acrylic-origami/tail-3dof/bom.xlsx

Sheet: Export Summary
This document was exported from Numbers. Each table was converted to an Excel worksheet. All other objects on each Numbers sheet were placed on separate worksheets. Please be aware that formula calculations may differ in Excel.
Numbers Sheet Name | Numbers Table Name | Excel Worksheet Name
Orders
 | Overview | Orders - Overview
 | Efficiency analysis | Orders - Efficiency analysis
 | “All Drawings from the Sheet” | Orders - Drawings
Home Depot
 | Table 1 | Home Depot
Lowe's
 | Table 1 | Lowe's
Fry's
 | Table 1 | Fry's
Digikey
 | Table 1 | Digikey
Amazon
 | Table 1 | Amazon
Hobbyking
 | Table 1 | Hobbyking
Amain
 | Table 1 | Amain
Hobbywing
 | Table 1 | Hobbywing
ServoCity
 | Table 1 | ServoCity
Mouser
 | Table 1 | Mouser
McMaster-Carr
 | Table 1 | McMaster-Carr

Sheet: Orders - Overview
Overview
index | Provider | Date | Desc | Base + Tax | Shipping
1 | Amazon | 2020-03-10 | Grey fur | $38.13 | 0
2 | Hobbyking | 2020-03-21 | Batteries & chargers | $78.85 | 0
3 | Home Depot | 2020-03-21 | Alum bar, plate, ? | $41.64 | 0
4 | Amazon | 2020-03-21 | Big assortment of hardware | $290.04 | 0
5 | Amazon | 2020-03-23 | Snips, shrink wrap & limit switches | $27.66 | 0
6 | Digikey | 2020-03-23 | LEDs, LED drivers, DC/DC, low-dropout comparators, PFETs, misc passives | $94.46 | $4.99
7 | Fry’s | 2020-03-28 | Shrink tubing, wire, breadboard | $23.97 | 0
8 | Lowe’s | 2020-03-28 | Clamps, 1/4” bore | $18.18 | 0
9 | DigiKey | 2020-03-30 | STM32, toggle switches, probes | $27.08 | $8.99
10 | AMain | 2020-03-30 | HS D645 servo | $38.33 | $1.99
11 | Home Depot | 2020-04-11 | Misc tools & mech | $24.22 | 0
12 | Home Depot | 2020-04-12 | ? | $12.88 | 0
13 | ServoCity | 2020-04-13 | Replacement gears for D645, shaft coupler | $29.53 | $6.99
14 | Hobbywing | 2020-04-13 | Sensored BLDC + ESC | $105.08 | 0
15 | DigiKey | 2020-04-13 | Nucleo + LED drivers + ADCs + NFETs | $80.32 | $4.99
16 | Treatstock | 2020-04-16 | Mounts & holders | $18.01 | $4.99
17 | Home Depot | 2020-04-25 | Solder, misc tools | $21.97 | 0
18 | Home Depot | 2020-04-26 | Lock wash, velcro | $4.52 | 0
19 | Home Depot | 2020-05-03 | Misc mech, fabric velcro | $11.03 | 0
20 | Fry’s | 2020-05-16 | USB cables | $13.09 | 0
21 | Home Depot | 2020-05-25 | Glue, M3 lock nuts, joystick, misc. fillup | $11.07 | 0
22 | Mouser | 2020-05-27 | Drivers, controller parts, mic #2 | 82.8 | $7.99
23 | RobotDyn | 2020-05-27 | STM-Minis | $9.18 | $4.29
24 | Amazon | 2020-06-01 | Fuses + batteries | $16.62 | 0
24 | Hobbywing | 2020-06-03 | Quicrun G2 25.5T | $51.47 | 0
25 | Home Depot | 2020-06-11 | Webbing strap (tie-down) | $5.00 | 0
26 | McMaster-Carr | 2020-06-21 | Torsion springs, M2.6 screws | $12.73 | $6.89
27
Totals |  |  |  | 1187.86 | 52.11
Grand total |  |  |  | 1239.97

Sheet: Orders - Efficiency analysis
Efficiency analysis
 | Loss | Unused | Oversupplied | Tools | Total loss (+ tax, w/o ship) | Non-tool total (+tax, w/o ship) | Efficiency
 | 153.167 | 151.45 | 156.1614 | 142.1 | 503.400402 | 1032.61575 | 0.5124997832

Sheet: Home Depot
Table 1
 | Date | Name | Unit price | QTY | Total | Loss | Unused | Oversupplied | Tool
 | 2020-04-11 | Slim taper file | 5.97 | 1 | 5.97 |  |  |  | 1
 | 2020-04-11 | 9/64” bit | 1.97 | 1 | 1.97 |  |  |  | 1
 | 2020-04-11 | M3 lock washers | 0.65 | 1 | 0.65
 | 2020-04-11 | Dewalt snap blades | 2.38 | 1 | 2.38 |  |  |  | 1
 | 2020-04-11 | #8-32 3/8” machine screws | 1.18 | 1 | 1.18
 | 2020-04-11 | 11/32” bit | 4.97 | 1 | 4.97
 | 2020-04-11 | M3 lock nuts 4pk | 0.98 | 4 | 3.92
 | 2020-04-11 | #6-32 3/8” machine screws | 1.18 | 1 | 1.18
 | 2020-04-25 | 10A fuses | 2.25 | 1 | 2.25
 | 2020-04-25 | Micro screwdriver set | 2.97 | 1 | 2.97 |  |  |  | 1
 | 2020-04-25 | Lead-free solder | 9.47 | 1 | 9.47
 | 2020-04-25 | 10pc SAE imperial hex keys | 5.47 | 1 | 5.47 |  |  |  | 1
 | 2020-04-26 | #8 lock washers | 1.18 | 1 | 1.18 |  | 1
 | 2020-04-26 | Industrial-strength stick-on Velcro | 2.97 | 1 | 2.97 |  |  | 0.7
 | 2020-05-03 | Fabric velcro | 5.97 | 1 | 5.97 |  |  | 0.9
 | 2020-05-03 | Nylon spacers 2pk | 0.62 | 1 | 0.62
 | 2020-05-03 | #6-32 3/4” machine screws | 1.18 | 1 | 1.18
 | 2020-05-03 | #6-32 1-1/4” machine screws | 1.18 | 1 | 1.18
 | 2020-05-03 | #6-32 1/2” machine screws | 1.18 | 1 | 1.18

Sheet: Lowe's
Table 1
 | Date | Name | Unit price | QTY | Total | Loss | Unused | Oversupplied | Tool | Loss $ | Unused $ | Oversupplied $ | Tool $
 | 2020-04-11 | C-clamp | 6.48 | 2 | 12.96 |  |  |  | 1 | 0 | 0 | 0 | 6.48
 |  | 1/4” bore bit | 3.68 | 1 | 3.68 |  |  |  | 1 | 0 | 0 | 0 | 3.68

Sheet: Fry's
Table 1
 | Date | Name | Unit price | QTY | Total | Loss | Unused | Oversupplied | Tool | Loss $ | Unused $ | Oversupplied $ | Tool $
 | 2020-03-28 | 1/4”x4’ shrink wrap tube | 2.99 | 2 | 5.98 |  |  |  |  | 0 | 0 | 0 | 0
 | 2020-03-28 | Electrical tape | 0.99 | 1 | 0.99 |  |  |  |  | 0 | 0 | 0 | 0
 | 2020-03-28 | 22AWG stranded wire 25’ | 5.99 | 1 | 5.99 |  |  |  |  | 0 | 0 | 0 | 0
 | 2020-03-28 | 3A diode | 0.99 | 1 | 0.99 |  |  |  |  | 0 | 0 | 0 | 0
 | 2020-03-28 | Mini zip ties | 3.99 | 1 | 3.99 |  |  | 0.9 |  | 0 | 0 | 3.591 | 0
 | 2020-03-28 | Mini breadboard | 5.99 | 1 | 5.99 | 1 |  |  |  | 5.99 | 0 | 0 | 0
 | 2020-05-16 | PPA USB-C to USB 3.1 OTG Cable Adapter | 6.99 | 1 | 6.99 |  |  |  | 1 | 0 | 0 | 0 | 6.99
 | 2020-05-16 | Rhino 2xUSB to Mini-USB Cable | 4.99 | 1 | 4.99 |  |  |  | 1 | 0 | 0 | 0 | 4.99

Sheet: Digikey
Table 1
 | Date | Name | Unit price | QTY | Total | Loss | Unused | Oversupplied | Tool | Loss $ | Unused $ | Oversupplied $ | Tool $
 | 2020-03-23 | 20W ADJUSTABLE DC-DC BUCK CONVER | 4.95 | 1 | 4.95 |  |  |  | 1 | 0 | 0 | 0 | 4.95 | 0
 | 2020-03-23 | IC GATE DRVR LOW-SIDE 8DIP | 0.89 | 3 | 2.67 |  | 3 |  |  | 0 | 2.67 | 0 |  | 0
 | 2020-03-23 | RADIAL PTC RESETTABLE FUSE, 1.2A | 0.35 | 4 | 1.4 |  |  |  |  | 0 | 0 | 0 |  | 1.4
 | 2020-03-23 | IC DRVR DOT MATRIX 28TSSOP | 6.27 | 3 | 18.81 | 3 |  |  |  | 18.81 | 0 | 0 |  | 0
 | 2020-03-23 | WINDOW COMPARATOR | 2.05 | 4 | 8.2 | 4 |  |  |  | 8.2 | 0 | 0 |  | 0
 | 2020-03-23 | HOOK-UP SOLID 24AWG 300V YEL 5' | 0.97 | 1 | 0.97 |  |  |  |  | 0 | 0 | 0 |  | 0.97
 | 2020-03-23 | HOOK-UP STRND 24AWG RED FEET | 0.354 | 5 | 1.77 |  |  |  |  | 0 | 0 | 0 |  | 1.77
 | 2020-03-23 | CAP CER 0.1UF 50V Z5U RADIAL | 0.24 | 3 | 0.72 |  |  |  |  | 0 | 0 | 0 |  | 0.72
 | 2020-03-23 | CAP ALUM POLY 560UF 20% 6.3V T/H | 0.77 | 2 | 1.54 |  |  |  |  | 0 | 0 | 0 |  | 1.54
 | 2020-03-23 | SMT ADAPTERS 3 PACK 28SOIC/TSSOP | 4.95 | 1 | 4.95 | 0.66 |  |  |  | 3.267 | 0 | 0 |  | 0
 | 2020-03-23 | SOT23 TO DIP ADAPTER | 0.95 | 4 | 3.8 | 3 |  |  |  | 2.85 | 0 | 0 |  | 0
 | 2020-03-23 | MOSFET P-CH 100V 15A TO220-3 | 1.59 | 5 | 7.95 |  | 3 |  |  | 0 | 4.77 | 0 |  | 0
 | 2020-03-23 | LED WHITE 5MM ROUND T/H | 0.2154 | 132 | 28.43 |  |  | 60 |  | 0 | 0 | 12.924 |  | 0
 | 2020-03-30 | SWITCH TOGGLE SPDT 5A 120V | 1.87 | 4 | 7.48 |  |  | 3 |  | 0 | 0 | 5.61 |  | 0
 | 2020-03-30 | DISCOVERY STM32F10X EVAL BRD | 9.88 | 1 | 9.88 |  |  |  | 4 | 0 | 0 | 0 |  | 0
 | 2020-03-30 | GATOR CLIP STEEL NON-INSUL 10A | 0.23 | 4 | 0.92 |  |  | 2 |  | 0 | 0 | 0.46 | 4 | 0
 | 2020-03-30 | CONN BANANA PLUG SOLDER BLUE | 0.95 | 2 | 1.9 |  |  |  | 2 | 0 | 0 | 0 | 2 | 0
 | 2020-03-30 | CONN PWR JACK 2.5X5.5MM SOLDER | 0.89 | 2 | 1.78 |  | 1 |  | 1 | 0 | 0.89 | 0 |  | 0
 | 2020-03-30 | DIODE GEN PURP 100V 200MA DO35 | 0.1 | 4 | 0.4 |  |  |  |  | 0 | 0 | 0 |  | 0.4
 | 2020-03-30 | DIODE SCHOTTKY 30V 200MA DO35 | 0.47 | 1 | 0.47 |  |  |  |  | 0 | 0 | 0 |  | 0.47
 | 2020-04-13 | IC OPAMP GP 1 CIRCUIT 8DIP | 0.3 | 4 | 1.2 |  |  | 2 |  | 0 | 0 | 0.6 |  | 0
 | 2020-04-13 | IC ADC 10BIT SAR 8DIP | 1.79 | 3 | 5.37 |  |  | 1 |  | 0 | 0 | 1.79 |  | 0
 | 2020-04-13 | RES 0.01 OHM 1% 3W RADIAL | 0.76 | 4 | 3.04 |  |  | 2 |  | 0 | 0 | 1.52 |  | 0
 | 2020-04-13 | SMT ADAPTERS 3 PACK 28SOIC/TSSOP | 4.95 | 1 | 4.95 | 3 |  |  |  | 14.85 | 0 | 0 |  | 0
 | 2020-04-13 | IC DRVR DOT MATRIX 28TSSOP | 6.27 | 3 | 18.81 | 1 |  | 1 |  | 6.27 | 0 | 6.27 |  | 0
 | 2020-04-13 | COUPLER FLEX SHAFT ALUM 5MM-5MM | 4.95 | 1 | 4.95 |  | 1 |  |  | 0 | 4.95 | 0 |  | 0
 | 2020-04-13 | MOSFET N-CHA 60V 37.2A TO220AB | 0.83 | 6 | 4.98 |  |  | 3 |  | 0 | 0 | 2.49 |  | 0
 | 2020-04-13 | NUCLEO-64 STM32F072RB EVAL BRD | 10.99 | 1 | 10.99 |  | 0.5 |  |  | 0 | 5.495 | 0 |  | 0
 | 2020-04-13 | STM32 NUCLEO-32 DEVELOPMENT BOAR | 10.97 | 1 | 10.97 |  | 1 |  |  | 0 | 10.97 | 0 |  | 0
 | 2020-04-13 | IC REG LINEAR 3.3V 250MA TO92-3 | 0.37 | 3 | 1.11 |  |  | 1 |  | 0 | 0 | 0.37 |  | 0
 | 2020-04-13 | DIODE SCHOTTKY 40V 350MA DO35 | 0.4 | 2 | 0.8 |  |  |  |  | 0 | 0 | 0 |  | 0.8
 | 2020-04-13 | IC GATE DRVR LOW-SIDE 8DIP | 1.21 | 4 | 4.84 |  | 4 |  |  | 0 | 4.84 | 0 |  | 0
 |  |  |  |  |  |  |  |  |  | 0 | 0 | 0
 |  |  |  |  |  |  |  |  |  | 0 | 0 | 0
 |  |  |  |  |  |  |  |  |  | 0 | 0 | 0
 |  |  |  |  |  |  |  |  |  | 0 | 0 | 0
 |  |  |  |  |  |  |  |  |  | 0 | 0 | 0
 |  |  |  |  |  |  |  |  |  | 0 | 0 | 0
 |  |  |  |  |  |  |  |  |  | 0 | 0 | 0
 |  |  |  |  |  |  |  |  |  | 0 | 0 | 0
 |  |  |  |  |  |  |  |  |  | 0 | 0 | 0
 |  |  |  |  |  |  |  |  |  | 0 | 0 | 0
 |  |  |  |  |  |  |  |  |  | 0 | 0 | 0
 |  |  |  |  |  |  |  |  |  | 0 | 0 | 0
 |  |  |  |  |  |  |  |  |  | 0 | 0 | 0
 |  |  |  |  |  |  |  |  |  | 0 | 0 | 0
 |  |  |  |  |  |  |  |  |  | 0 | 0 | 0
 |  |  |  |  |  |  |  |  |  | 0 | 0 | 0
 |  |  |  |  |  |  |  |  |  | 0 | 0 | 0
 |  |  |  |  |  |  |  |  |  | 0 | 0 | 0
 |  |  |  |  |  |  |  |  |  | 0 | 0 | 0
 |  |  |  |  |  |  |  |  |  | 0 | 0 | 0
 |  |  |  |  |  |  |  |  |  | 0 | 0 | 0
 |  |  |  |  |  |  |  |  |  | 0 | 0 | 0
 |  |  |  |  |  |  |  |  |  | 0 | 0 | 0
 |  |  |  |  |  |  |  |  |  | 0 | 0 | 0
 |  |  |  |  |  |  |  |  |  | 0 | 0 | 0
 |  |  |  |  |  |  |  |  |  | 0 | 0 | 0
 |  |  |  |  |  |  |  |  |  | 0 | 0 | 0
 |  |  |  |  |  |  |  |  |  | 0 | 0 | 0
 |  |  |  |  |  |  |  |  |  | 0 | 0 | 0
 |  |  |  |  |  |  |  |  |  | 0 | 0 | 0
 |  |  |  |  |  |  |  |  |  | 0 | 0 | 0
 |  |  |  |  |  |  |  |  |  | 0 | 0 | 0
 |  |  |  |  |  |  |  |  |  | 0 | 0 | 0
 |  |  |  |  |  |  |  |  |  | 0 | 0 | 0
 |  |  |  |  |  |  |  |  |  | 0 | 0 | 0
 |  |  |  |  |  |  |  |  |  | 0 | 0 | 0
 |  |  |  |  |  |  |  |  |  | 0 | 0 | 0

Sheet: Amazon
Table 1
 | Date | Name | Unit price | Qty | Total | Loss | Unused | Oversupplied | Temporary | Tool | Loss $ | Unused $ | Oversupplied $ | Tool $
 | 2020-03-23 | Micro Cutter | $8.43 | 1 | $8.43 |  |  |  |  | 1 | $0 | $0 | $0 | $8.43
 | 2020-03-23 | MCIGICM 127pcs Heat Shrink Tubing 2:1, Electrical Wire Cable Wrap Assortment Electric Insulation Heat Shrink Tube Kit (7 Sizes) | $4.99 | 1 | $4.99 |  |  | 0.75 |  |  | $0 | $0 | $3.7425 | $0
 | 2020-03-23 | uxcell a14061700ux0924 AC 125V 5A Hinge Lever Micro Limit Switch KW4-3Z-3 for Mill CNC (Pack of 5) | $4.75 | 1 | $4.75 |  |  | 0.6 |  |  | $0 | $0 | $2.85 | $0
 | 2020-03-23 | Pro'sKit 900-015 Helping Hands Soldering Aid | $7.20 | 1 | $7.20 |  |  |  |  | 1 | $0.00 | $0.00 | $0.00 | $7.20
 | 2020-03-21 | RobotDyn - Black Pill STM32, Original STM32F103C8T6 ARM Cortex-M3 128KB Minimum System Development Board. Pinheaders NOT Soldered | $9.90 | 2 | $19.80 | 1 |  |  |  |  | $9.90 | $0.00 | $0.00 | $0.00
 | 2020-03-21 | ZOSKAY 1X DS3218 Update servo 20KG Full Metal Gear Digital servo Baja servo Waterproof servo for Baja Cars(Control Angle 180) | $17.88 | 1 | $17.88 |  |  |  |  |  | $0 | $0 | $0 | $0
 | 2020-03-21 | KeeYees 10pcs 4 Channels IIC I2C Logic Level Converter Bi-Directional Module 3.3V to 5V Shifter for Arduino (Pack of 10) | $7.99 | 1 | $7.99 |  | 1 |  |  |  | $0 | $7.99 | $0 | $0
 | 2020-03-21 | REXQualis 22 Values 1/4W 1% Resistor Assortment Kit,10 Ohm - 1M Ohm (Pack of 650) | $9.99 | 1 | $9.99 |  |  | 0.75 |  |  | $0 | $0 | $7.4925 | $0
 | 2020-03-21 | MAIYUM 63-37 Tin Lead Rosin Core Solder Wire for Electrical Soldering (0.6mm 50g) | $7.59 | 1 | $7.59 |  |  |  |  |  | $0 | $0 | $0 | $0
 | 2020-03-21 | Weller WLC100 40-Watt Soldering Station | $38.97 | 1 | $38.97 |  |  |  |  | 1 | $0 | $0 | $0 | $38.97
 | 2020-03-21 | BTNOW 15 Set Plastic 1 Inch Flat Side Release Buckles and Tri-Glide Slides with 1 Roll 5 Yards Nylon Webbing Straps for DIY Making Luggage Strap, Pet Collar, Backpack Repairing | $7.99 | 1 | $7.99 |  |  | 0.5 |  |  | $0 | $0 | $3.995 | $0
 | 2020-03-21 | STEPPERONLINE Mounting Bracket for Nema 17 Stepper Motor (Economy Geared Stepper) Hobby CNC/3D Printer | $5.66 | 2 | $11.32 |  |  |  |  |  | $0 | $0 | $0 | $0
 | 2020-03-21 | STEPPERONLINE 51:1 Planetary Gearbox High Torque Nema 17 Stepper Motor Precision Camera DIY | $41.75 | 1 | $41.75 | 0.5 |  |  |  |  | $20.875 | $0 | $0 | $0
 | 2020-03-21 | 65.6ft/20M Electric Wire 22 Gauge, AWSOM Extension Wire Red Black 2 Wire Stranded Tinned Copper for 3528 LED Strip Lights, 12V DC Wire, Speaker, Doorbell Wire … | $7.58 | 1 | $7.58 |  |  |  |  |  | $0 | $0 | $0 | $0
 | 2020-03-21 | AUSTOR 100 Pcs PCB Board Kit Including 30 Pcs PCB Boards 30 Pcs 40 Pin 2.54mm Header Connector(Bonus: 10 Pcs 2P&3P Terminal Blocks and 30 Pcs Caps) | $15.99 | 1 | $15.99 |  |  | 0.85 |  |  | $0 | $0 | $13.5915 | $0
 | 2020-03-21 | 2 Pack 8mm Flange Coupling Connector, Rigid Guide Steel Model Coupler Accessory, Shaft Axis Fittings for DIY RC Model Motors, High Hardness Coupling Connector-Silver. (2 pcs 8mm) | $7.59 | 1 | $7.59 |  |  | 1 |  |  | $0 | $0 | $7.59 | $0
 | 2020-03-21 | Fairfield PF16B Poly-Fil Premium Polyester Fiber, 16 Oz, White | $9.00 | 1 | $9.00 |  |  | 0.5 |  |  | $0.00 | $0.00 | $4.50 | $0.00
 | 2020-03-21 | 12V 2A AC Power Replacement Adapter for Yamaha PSR-300 PSR-300M PSR-310 PSR-320 Keyboard Wall Charger Power Supply Cord | $6.99 | 1 | $6.99 |  |  |  |  | 1 | $0 | $0 | $0 | $6.99
 | 2020-03-21 | Maxmoral 2-Pack MP1584EN DC-DC Buck Converter Adjustable Step-Down Power Module 3A 24V to 12V 9V 5V 3V | $5.99 | 1 | $5.99 |  |  |  |  |  | $0 | $0 | $0 | $0
 | 2020-03-21 | Sutemribor M3x6mmx0.5mm Stainless Steel Flat Washer, 100Pcs | $4.99 | 1 | $4.99 |  |  | 0.76 |  |  | $0 | $0 | $3.7924 | $0
 | 2020-03-21 | Uxcell a15060200ux0454 M3 25+6mm Male Female Thread Nylon Hex Standoff Spacer Pillar (Pack of 50) | $5.99 | 1 | $5.99 |  |  | 0.8 |  |  | $0 | $0 | $4.792 | $0
 | 2020-03-21 | Adafruit I2S MEMS Microphone Breakout - SPH0645LM4H (3421) | $9.42 | 1 | $9.42 | 1 |  |  |  |  | $9.42 | $0 | $0 | $0
 | 2020-03-21 | BIGTREETECH DIRECT TMC2209 V1.2 Stepper Motor Driver UART VS TMC2208 TMC2130 A4988 SKR V1.3 Pro Control Board 3D Printer Parts Mini E3 | $11.98 | 1 | $11.98 |  | 1 |  |  |  | $0 | $11.98 | $0 | $0
 | 2020-03-21 | Britt's Knits Women's Lurex Shimmer 'n Chic Stretch Knit Gloves, brown, One size | $8.14 | 1 | $8.14 |  |  |  |  |  | $0 | $0 | $0 | $0
 | 2020-03-21 | Hobbypark 2pcs Metal Aluminum 25T Servo Horn Steering Arms (Double & Single) for RC Models Car Truck Buggy Replacement Parts (Red) | $7.99 | 1 | $7.99 |  |  |  |  |  | $0 | $0 | $0 | $0
 | 2020-03-21 | ARCELI 120Pcs/lot 1uF-470uF 12Values10pcs Aluminum Electrolytic Capacitor Assortment Kit for 1UF 2.2UF 3.3UF 4.7UF 10UF 22UF 33UF 47UF 100UF 220UF 330UF 470UF | $5.99 | 1 | $5.99 |  |  | 0.75 |  |  | $0 | $0 | $4.4925 | $0
 | 2020-03-21 | Desoldering Vacuum Pump, Large, Teflon Tip, Antistatic | $5.69 | 1 | $5.69 |  |  |  |  | 1 | $0 | $0 | $0 | $5.69
 | 2020-03-21 | QTEATAK 300 Pcs M3 Stainless Steel Hex Socket Head Cap Screws Nuts Assortment Kit, Allen Wrench Drive, Precise Metric Bolts and Nuts Set for 3D Printed Project | $7.44 | 1 | $7.44 |  |  | 0.5 |  |  | $0 | $0 | $3.72 | $0
 | 2020-03-21 | Chessex Dice: Velour Cloth Dice Bag - Small (4 x 6) - BLACK by Chessex | $5.99 | 1 | $5.99 |  |  |  |  |  | $0 | $0 | $0 | $0
 | 2020-03-10 | Shannon Fabrics Luxury Faux Fur Candy Shag Fabric by The Yard, Grey | $34.98 | 1 | $34.98 | 0.25 |  | 0.5 |  |  | $8.74 | $0.00 | $17.49 | $0.00
 | 2020-06-01 | Thermometers Replaced Battery AAA Remote Cell 1.5V Carbon Zinc Batteries r03p um4 Count 8pcs | $5.19 | 1 | $5.19 |  |  |  |  |  | $0.00 | $0.00 | $0.00 | $0.00
 | 2020-06-01 | DMM-44/100 Multi-Meter Fuse 440mA 1000V Fluke 943121 (2 Pack) | $9.99 | 1 | $9.99 |  |  |  |  |  | $0.00 | $0.00 | $0.00 | $0.00
 |  |  |  |  |  |  |  |  |  |  | 0 | 0 | 0 | 0
 |  |  |  |  |  |  |  |  |  |  | 0 | 0 | 0 | 0
 |  |  |  |  |  |  |  |  |  |  | 0 | 0 | 0 | 0
 |  |  |  |  |  |  |  |  |  |  | 0 | 0 | 0 | 0
 |  |  |  |  |  |  |  |  |  |  | 0 | 0 | 0 | 0
 |  |  |  |  |  |  |  |  |  |  | 0 | 0 | 0 | 0
 |  |  |  |  |  |  |  |  |  |  | 0 | 0 | 0 | 0
 |  |  |  |  |  |  |  |  |  |  | 0 | 0 | 0 | 0
 |  |  |  |  |  |  |  |  |  |  | 0 | 0 | 0 | 0
 |  |  |  |  |  |  |  |  |  |  | 0 | 0 | 0 | 0
 |  |  |  |  |  |  |  |  |  |  | 0 | 0 | 0 | 0
 |  |  |  |  |  |  |  |  |  |  | 0 | 0 | 0 | 0
 |  |  |  |  |  |  |  |  |  |  | 0 | 0 | 0 | 0
 |  |  |  |  |  |  |  |  |  |  | 0 | 0 | 0 | 0
 |  |  |  |  |  |  |  |  |  |  | 0 | 0 | 0 | 0
 |  |  |  |  |  |  |  |  |  |  | 0 | 0 | 0 | 0
 |  |  |  |  |  |  |  |  |  |  | 0 | 0 | 0 | 0
 |  |  |  |  |  |  |  |  |  |  | 0 | 0 | 0 | 0
 |  |  |  |  |  |  |  |  |  |  | 0 | 0 | 0 | 0
 |  |  |  |  |  |  |  |  |  |  | 0 | 0 | 0 | 0
 |  |  |  |  |  |  |  |  |  |  | 0 | 0 | 0 | 0
 |  |  |  |  |  |  |  |  |  |  | 0 | 0 | 0 | 0
 |  |  |  |  |  |  |  |  |  |  | 0 | 0 | 0 | 0
 |  |  |  |  |  |  |  |  |  |  | 0 | 0 | 0 | 0
 |  |  |  |  |  |  |  |  |  |  | 0 | 0 | 0 | 0
 |  |  |  |  |  |  |  |  |  |  | 0 | 0 | 0 | 0
 |  |  |  |  |  |  |  |  |  |  | 0 | 0 | 0 | 0
 |  |  |  |  |  |  |  |  |  |  | 0 | 0 | 0 | 0
 |  |  |  |  |  |  |  |  |  |  | 0 | 0 | 0 | 0
 |  |  |  |  |  |  |  |  |  |  | 0 | 0 | 0 | 0
 |  |  |  |  |  |  |  |  |  |  | 0 | 0 | 0 | 0
 |  |  |  |  |  |  |  |  |  |  | 0 | 0 | 0 | 0
 |  |  |  |  |  |  |  |  |  |  | 0 | 0 | 0 | 0
 |  |  |  |  |  |  |  |  |  |  | 0 | 0 | 0 | 0
 |  |  |  |  |  |  |  |  |  |  | 0 | 0 | 0 | 0
 |  |  |  |  |  |  |  |  |  |  | 0 | 0 | 0 | 0
 |  |  |  |  |  |  |  |  |  |  | 0 | 0 | 0 | 0

Sheet: Hobbyking
Table 1
 | Date | Name | Unit price | Qty | Total | Loss | Unused | Oversupplied | Temporary | Tool
 | 2020-03-21 | Turnigy 2000mAh 1S 1C Lipo w/ 2 Pin JST-PH Connector | $4.39 | 5 | $21.95 |  |  | 3
 |  | Turnigy 1700mAh 2S 20C Lipo Pack (Suits 1/16th Monster Beatle, SCT & Buggy) | $8.82 | 3 | $26.46
 |  | ISDT UC4 1S Smart Charger | $10.93 | 1 | $10.93 |  |  |  |  | 1
 |  | IMAX B6 DC Charger 5A 50W (Copy) | $12.04 | 1 | $12.04 |  |  |  |  | 1
 |  | 80cm Twisted Servo Lead Extension (JR) 22AWG (5pcs/bag) | $5.57 | 1 | $5.57
 |  | XT60 Harness for 2 Packs in Parallel (1pc) | $1.90 | 1 | $1.90

Sheet: Amain
Table 1
 | Date | Name | Unit price | Qty | Total | Loss | Unused | Oversupplied | Temporary | Tool
 | 2020-03-30 | Hitec D645MW High Torque Metal Gear Servo (High Voltage) | 39.99 | 1 | 39.99 | 0.5

Sheet: Hobbywing
Table 1
 | Date | Name | Unit price | Qty | Total | Loss | Unused | Oversupplied | Temporary | Tool
 | 2020-04-13 | QUICRUN 3650 Sensored brushless motor G2 - QR 21.5T | $47.99 | 1 | $47.99 | 0.5 | 0.5
 | 2020-04-13 | QUICRUN 10 Brushless ESC Sensored (2-3S) - QUICRUN 10BL60 Sensored | $49.99 | 1 | $49.99 |  | 1
 | 2020-06-03 | QUICRUN 3650 Sensored brushless motor G2 - QR 21.5T | $47.99 | 1 | $47.99

Sheet: ServoCity
Table 1
 | Date | Name | Unit price | Qty | Total | Loss | Unused | Oversupplied | Temporary | Tool
 |  | Set Screw Shaft Couplers | $4.99 | 1 | $4.99
 |  | Servo Grease | $6.55 | 1 | $6.55
 |  | 55303 Hitec OEM Replacement Gear Set | $17.99 | 1 | $17.99 |  |  | 0.5

Sheet: Mouser
Table 1
 | Date | Name | Unit price | Qty | Total | Loss | Unused | Oversupplied | Temporary | Tool
 | 2020-05-27 | B-G431B-ESC1 Development Boards & Kits - ARM Development Boards & Kits - ARM 16/32-BITS MICROS | $18.48 | 1 | $18.48
 | 2020-05-27 | 173-9-230P Thermal Interface Products Thermal Interface Products THERMAL INSULATOR .50 C/W | $0.32 | 12 | $3.88 |  |  | 11
 | 2020-05-27 | 3421 Audio IC Development Tools Audio IC Development Tools I2S MEMS Microphone Breakout | $6.95 | 1 | $6.95 |  | 1
 | 2020-05-27 | RL6105BK Enclosures, Boxes, & Cases Enclosures, Boxes, & Cases SHALLOW LID NO FLG 3.15 x2.36 x1.18 BLK | $2.87 | 1 | $2.87
 | 2020-05-27 | 1551LGY Enclosures, Boxes, & Cases Enclosures, Boxes, & Cases Mini/Handheld/ABS 3.15x1.58x0.59" Grey | $2.22 | 1 | $2.22
 | 2020-05-27 | THB001P Joysticks Joysticks SWITCH THUMSTICK | $1.40 | 3 | $4.20 |  |  | 1
 | 2020-05-27 | TC426CPA Gate Drivers Gate Drivers 1.5A Dual H-Speed | $1.21 | 3 | $3.63 |  | 3
 | 2020-05-27 | DMT6009LCT MOSFET MOSFET MOSFET BVDSS: 41V-60V | $0.82 | 3 | $2.46 |  | 3
 | 2020-05-27 | IRF5305PBF MOSFET MOSFET MOSFT PCh -55V -31A 60mOhm 42nC | $1.17 | 4 | $4.68 |  |  | 3
 | 2020-05-27 | 1N5817-T Schottky Diodes & Rectifiers Schottky Diodes & Rectifiers 20V 1A | $0.14 | 10 | $1.40 |  | 10
 | 2020-05-27 | K104K15X7RF53H5 Multilayer Ceramic Capacitors MLCC - Leaded Multilayer Ceramic Capacitors MLCC - Leaded 0.1uF 50volts 10% X7R 5mm LS | $0.10 | 10 | $1.00 |  |  | 8
 | 2020-05-27 | LP2950CZ-3.3RAG LDO Voltage Regulators LDO Voltage Regulators 3.3V 100mA Low Power | $0.76 | 4 | $3.04 |  | 4
 | 2020-05-27 | SN74HCT125NE4 Buffers & Line Drivers Buffers & Line Drivers Tri-State Quad Bus | $0.54 | 3 | $1.62 |  | 3
 | 2020-05-27 | LD1117V50 LDO Voltage Regulators LDO Voltage Regulators 5.0 0.8A Positive | $0.55 | 1 | $0.55 |  | 1
 | 2020-05-27 | NUCLEO-F303K8 Development Boards & Kits - ARM Development Boards & Kits - ARM STM32 Nucleo Development Board | $10.76 | 1 | $10.76
 | 2020-05-27 | 4688 Screws & Fasteners Screws & Fasteners NYLON HEX NUT | $0.14 | 10 | $1.38 |  |  | 8
 | 2020-05-27 | 29341 Screws & Fasteners Screws & Fasteners M3 6.0mm NYL SCRW | $0.20 | 10 | $1.98 |  |  | 8
 | 2020-05-27 | 3054 Screws & Fasteners Screws & Fasteners SHOULDER WASHER | $0.15 | 10 | $1.50 |  | 10
 | 2020-05-27 | 274-3AB Heat Sinks Heat Sinks HEATSINK | $0.23 | 5 | $1.15 |  |  | 4
 | 2020-05-27 | P120K-F20AR100K Potentiometers Potentiometers 1/20W 100K Ohms 20% 12mm ROTARY POT | $0.58 | 1 | $0.58 |  | 1
 | 2020-05-27 | 4JBLK Switch Bezels / Switch Caps Switch Bezels / Switch Caps 12 X 12MM SQ BLK | $0.12 | 1 | $0.12
 | 2020-05-27 | TL2201EEXA Tactile Switches Tactile Switches 100mA 30VDC Latching DPDT | $0.68 | 1 | $0.68
 | 2020-05-27 | 400R0111-22-9 Hook-up Wire Hook-up Wire 400R0111-22-9 Price Per Foot | $0.11 | 10 | $1.07

Sheet: McMaster-Carr
Table 1
 | Date | Name | Unit price | Qty | Total | Loss | Unused | Oversupplied | Temporary | Tool
 | 2020-06-21 | 180 Degree Right-Hand Wound, 0.982" OD, 0.105" Wire Diameter (https://www.mcmaster.com/9271K691/) | $1.97 | 1 | $1.97
 | 2020-06-21 | Torsion Spring, 180 Degree Right-Hand Wound, 0.92" OD, Packs of 1 (https://www.mcmaster.com/9271K689) | $1.81 | 1 | $1.81
 | 2020-06-21 | Torsion Spring, 180 Degree Right-Hand Wound, 1.348" OD, Packs of 1 (https://www.mcmaster.com/9271K693/) | $2.12 | 1 | $2.12
 | 2020-06-21 | Steel Pan Head Slotted Screws, M2.6 x 0.45 mm Thread, 12 mm Long, Packs of 100 (https://www.mcmaster.com/90353A115) | $5.78 | 1 | $5.78
