acrylic-origami/tail-3dof/stm/tail-ctrl/Src/main.c

/**
  ******************************************************************************
  * @file           : main.c
  * @brief          : Main program body
  ******************************************************************************
  ** This notice applies to any and all portions of this file
  * that are not between comment pairs USER CODE BEGIN and
  * USER CODE END. Other portions of this file, whether 
  * inserted by the user or by software development tools
  * are owned by their respective copyright owners.
  *
  * COPYRIGHT(c) 2020 STMicroelectronics
  *
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
  ******************************************************************************
  */
/* Includes ------------------------------------------------------------------*/
#include "main.h"
#include "stm32f1xx_hal.h"
#include "dma.h"
#include "i2c.h"
#include "spi.h"
#include "tim.h"
#include "usart.h"
#include "gpio.h"

/* USER CODE BEGIN Includes */
#include "consts.h"
/* USER CODE END Includes */


/* USER CODE BEGIN PV */

//// AS1130 ////
as1130_state_t AS1130_setup_state = ONOFF;
const uint8_t AS1130_ONOFF_SEL[AS1130_ONOFF_SEL_SIZE] = { AS1130_REG_SEL_ADDR, AS1130_ONOFF_FR0_REG };
const uint8_t AS1130_ONOFF_DATA[AS1130_ONOFF_DATA_SIZE] = { // enable all LEDs
	0xFF, 0x07, // select PWM frame 0
	// turn on all
	0xFF, 0x07, 0xFF, 0x07, 0xFF, 0x07, 0xFF, 0x07, 0xFF, 0x07, 0xFF, 0x07, 0xFF, 0x07
};
const uint8_t AS1130_PWM_SEL[AS1130_PWM_SEL_SIZE] = { AS1130_REG_SEL_ADDR, AS1130_PWM_SET0_REG };

// SPH0615
#define MIC_BUFFER_SIZE 1024
uint8_t mic_buffer[MIC_BUFFER_SIZE] = {0};

/* USER CODE END PV */

void SystemClock_Config(void);

/* USER CODE BEGIN PFP */

/* USER CODE END PFP */

/* USER CODE BEGIN 0 */
// note differing units: stepper is in integer 8-steps (256-scaled)
// servos are in 1/256 fractions of total range, 256-scaled
// for 51:1 stepper gearmotor, this is 0.28deg/256
// for 180deg servo, this is 0.7deg/256

// velocity units are also different
// stepper velocity is the ground truth: it's exponential in this velocity figure
// from 0 to 7, goes from 128 to 1
// servo velocity needs to compensate for the changes in stepper velocity because
// it's updated on the stepper SPI interrupt
// the increment per tick should be normalized by the stepper velocity
// these are for the interrupt's convenience
uint32_t target_256[3] = {0}, target_v_256[3] = {0};
volatile uint32_t cur_256[3] = {0}, cur_v_256[3] = {0};

uint8_t px[PX_SIZE];
volatile uint8_t px_idx = PX_SIZE;
extern I2C_HandleTypeDef hi2c2;
/* USER CODE END 0 */

/**
  * @brief  The application entry point.
  *
  * @retval None
  */
int main(void)
{
  /* MCU Configuration----------------------------------------------------------*/

  /* Reset of all peripherals, Initializes the Flash interface and the Systick. */
  HAL_Init();

  /* Configure the system clock */
  SystemClock_Config();

  /* Initialize all configured peripherals */
  MX_GPIO_Init();
  MX_DMA_Init();
  MX_TIM3_Init();
  MX_USART2_UART_Init();
  MX_I2C2_Init();
  MX_SPI2_Init();
  MX_TIM1_Init();
  MX_TIM4_Init();
  MX_TIM2_Init();
  /* USER CODE BEGIN 2 */
  AS1130_Init();
  SPH0645_Init();
  /* USER CODE END 2 */

  /* Infinite loop */
  /* USER CODE BEGIN WHILE */
  while (1)
  {

  /* USER CODE END WHILE */

  /* USER CODE BEGIN 3 */

  }
  /* USER CODE END 3 */

}

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
/* USER CODE BEGIN 4 */
void AS1130_Init(void) {
	HAL_Delay(10); // give AS1130 >5ms to setup I2C address (as spec'd)
	while(AS1130_setup_state != READY || hi2c2->State != HAL_I2C_STATE_READY) {
		if(hi2c2->State == HAL_I2C_STATE_READY) {
			switch(AS1130_setup_state) {
			case ONOFF_SEL:
				HAL_I2C_Master_Transmit_IT(hi2c2, AS1130_ADDR, AS1130_ONOFF_SEL, AS1130_ONOFF_SEL_SIZE);
				AS1130_setup_state = ONOFF;
				break;
			case ONOFF:
				HAL_I2C_Master_Transmit_IT(hi2c2, AS1130_ADDR, AS1130_ONOFF_DATA, AS1130_ONOFF_DATA_SIZE);
				AS1130_setup_state = PWM_SEL;
				break;
			case PWM_SEL:
				HAL_I2C_Master_Transmit_IT(hi2c2, AS1130_ADDR, AS1130_PWM_SEL, AS1130_PWM_SEL_SIZE);
				AS1130_setup_state = READY;
				break;
			default:
				// for now, race condition between while and if check
				break;
			}
		}
	}
}
void SPH0645_Init(void) {
	// wow i really hope this is all i need to do
	HAL_SPI_Receive_DMA(hspi2, mic_buffer, MIC_BUFFER_SIZE);
}
/* USER CODE END 4 */
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
