acrylic-origami/tail-3dof/stm/tail-ctrl/tail-ctrl.ioc

Mcu.UserName=STM32F103C8Tx
PA0-WKUP.Signal=S_TIM2_CH1_ETR
PA1.Signal=S_TIM2_CH2
PA12.Signal=S_TIM1_ETR
PA2.Signal=USART2_TX
PA3.Signal=GPXTI3
PA5.Signal=GPIO_Output
PA6.Signal=S_TIM3_CH1
PA8.Signal=S_TIM1_CH1
PB10.Signal=I2C2_SCL
PB11.Signal=I2C2_SDA
PB13.Signal=SPI2_SCK
PB14.Signal=SPI2_MISO
PB15.Signal=SPI2_MOSI
PC14-OSC32_IN.Signal=RCC_OSC32_IN
PC15-OSC32_OUT.Signal=RCC_OSC32_OUT
PD0-OSC_IN.Signal=RCC_OSC_IN
PD1-OSC_OUT.Signal=RCC_OSC_OUT
