acrylic-origami/tail-3dof/stm/f072_test/Src/main.c

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

/* Includes ------------------------------------------------------------------*/
#include "main.h"

I2C_HandleTypeDef hi2c1;

SPI_HandleTypeDef hspi1;

TIM_HandleTypeDef htim1;
TIM_HandleTypeDef htim3;
DMA_HandleTypeDef hdma_tim3_ch4_up;

UART_HandleTypeDef huart2;

/* USER CODE BEGIN PV */
#define AS1130_SETUP_NUM_STEPS 16
const uint8_t AS1130_setup_sizes[AS1130_SETUP_NUM_STEPS] = {
  2, 2, // CONFIG
  2, 2, // CLK
  2, 2, // CURR
  2, 2, // DSP/
  2, 2, // SHDN
  2, 2, // PIC_EN
  2, 25, // ON-OFF
  2, 157, // PX0
}; // configuration problem: can't change frames after either on-off register or pic-en it seems
const uint8_t AS1130_setup[] = {
  0xFD, 0xC0,
  0x06, 0b10100001, // CONFIG

  0xFD, 0xC0,
  0x0B, 0b1110, // CLK

  0xFD, 0xC0,
  0x05, 0x40, // CURR

  0xFD, 0xC0,
  0x04, 0xEB, // DSP

  0xFD, 0xC0,
  0x09, 0b10111, // SHDN

  0xFD, 0xC0,
  0x00, 0x40, // PIC_EN

  0xFD, 0x01, // ON-OFF
  0x00,
    0xFF, 0x07, // select PWM frame 0
    0xFF, 0x07, 0xFF, 0x07, 0xFF, 0x07, 0xFF, 0x07, 0xFF, 0x07, 0xFF, 0x07, 0xFF, 0x07, 0xFF, 0x07, 0xFF, 0x07, 0xFF, 0x07, 0xFF, 0x07,

  0xFD, 0x40,
  0x00, // PX
	0,0,0,0,0,0,0,0,0,0,0,0,0,0,0,0,0,0,0,0,0,0,0,0, // no blink
	// unset all pxs
	0, 0, 0, 0, 0, 0, 0, 0, 0, 0, 0, 0,
	0, 0, 0, 0, 0, 0, 0, 0, 0, 0, 0, 0,
	0, 0, 0, 0, 0, 0, 0, 0, 0, 0, 0, 0,
	0, 0, 0, 0, 0, 0, 0, 0, 0, 0, 0, 0,
	0, 0, 0, 0, 0, 0, 0, 0, 0, 0, 0, 0,
	0, 0, 0, 0, 0, 0, 0, 0, 0, 0, 0, 0,
	0, 0, 0, 0, 0, 0, 0, 0, 0, 0, 0, 0,
	0, 0, 0, 0, 0, 0, 0, 0, 0, 0, 0, 0,
	0, 0, 0, 0, 0, 0, 0, 0, 0, 0, 0, 0,
	0, 0, 0, 0, 0, 0, 0, 0, 0, 0, 0, 0,
	0, 0, 0, 0, 0, 0, 0, 0, 0, 0, 0, 0,

};
#define PWM_PRE_SIZE 2
uint8_t PWM_PRE[PWM_PRE_SIZE] = { 0xFD, 0x01 };
// uint8_t PWM_ADDR = 0x18;
volatile uint8_t px[PX_SIZE] = { 0 };
uint8_t e = 0;

// TEMP

uint8_t d[12] = { 0 };
uint8_t g[24] = { 0 };
uint8_t a[32] = { 0 };
const uint8_t f[2] = { 0xFD, 0x01 };
const uint8_t h[2] = { 0xFD, 0xC0 };
const uint8_t k[2] = { 0xFD, 0x40 };
uint8_t z = 0x0;
uint8_t zz = 0x20;
uint8_t zzz = 0x0E;

/* USER CODE END PV */

void SystemClock_Config(void);
static void MX_GPIO_Init(void);
static void MX_DMA_Init(void);
static void MX_USART2_UART_Init(void);
static void MX_I2C1_Init(void);
static void MX_SPI1_Init(void);
static void MX_TIM3_Init(void);
static void MX_TIM1_Init(void);
/* USER CODE BEGIN PFP */
static void AS1130_Init(void);
static void AS1130_reg_dump(void);
/* USER CODE END PFP */

/* USER CODE BEGIN 0 */
uint8_t rx[2], config[2] = {0};
/* USER CODE END 0 */

/**
  * @brief  The application entry point.
  * @retval int
  */
int main(void)
{
  /* MCU Configuration--------------------------------------------------------*/

  /* Reset of all peripherals, Initializes the Flash interface and the Systick. */
  HAL_Init();

  /* Configure the system clock */
  SystemClock_Config();

  /* Initialize all configured peripherals */
  MX_GPIO_Init();
  MX_DMA_Init();
  MX_USART2_UART_Init();
  MX_I2C1_Init();
  MX_SPI1_Init();
  MX_TIM3_Init();
  MX_TIM1_Init();
  /* USER CODE BEGIN 2 */
  HAL_TIM_Base_Start(&htim1);
  htim3.Instance->CCER |= TIM_CCER_CC1E | TIM_CCER_CC2E | TIM_CCER_CC3E;
  htim3.Instance->CR1 |= TIM_CR1_CEN;

//  __HAL_TIM_SET_COMPARE(&htim3, TIM_CHANNEL_1, 150);
//  __HAL_TIM_SET_COMPARE(&htim3, TIM_CHANNEL_2, 1500);
//  __HAL_TIM_SET_COMPARE(&htim3, TIM_CHANNEL_3, 1000);

  HAL_GPIO_WritePin(GPIOC, GPIO_PIN_7, RESET);
  HAL_Delay(5);
  HAL_GPIO_WritePin(GPIOC, GPIO_PIN_7, SET);
  AS1130_Init();
  HAL_Delay(50);
//  uint8_t tims[] = {150, 160, 140};
//  uint8_t tim_idx = 32;
//  __HAL_TIM_SET_COMPARE(&htim3, TIM_CHANNEL_1, 150);
  uint8_t edge = 0;
//  HAL_I2C_Master_Transmit(&hi2c1, AS1130_ADDR, px, PX_SIZE, -1);

  /* USER CODE END 2 */

  /* Infinite loop */
  /* USER CODE BEGIN WHILE */
  uint8_t i = 0;
  while(1)
  {
    /* USER CODE END WHILE */

    /* USER CODE BEGIN 3 */
//	  if(HAL_GPIO_ReadPin(B1_GPIO_Port, B1_Pin) == GPIO_PIN_RESET && !edge) {
//		  edge = 1;
//	  	  if(hi2c1.State == HAL_I2C_STATE_READY) {
////	  		  px[(i >> 3) + 1] |= 1 << (i & 7);
////	  		  for(uint8_t j = 1; j < PX_SIZE; j++) {
////	  			  px[j] = 1 << (i & 7);
////	  		  }
////	  		  px[2] &= 0x1F; // preserve PWM frame
//	  		  px[0] = 0x18 + i;
//	  		  px[1] = 0x80;
//	  		  HAL_I2C_Master_Transmit(&hi2c1, AS1130_ADDR, px, 2, -1);
//	  	  }
//  		  i++;
//	  }
//	  if(HAL_GPIO_ReadPin(B1_GPIO_Port, B1_Pin) == GPIO_PIN_SET)
//		  edge = 0;
	  for(uint8_t i = 0; i < 132; i++) {
		  if(hi2c1.State == HAL_I2C_STATE_READY) {
	//	  		  px[(i >> 3) + 1] |= 1 << (i & 7);
	//	  		  for(uint8_t j = 1; j < PX_SIZE; j++) {
	//	  			  px[j] = 1 << (i & 7);
	//	  		  }
	//	  		  px[2] &= 0x1F; // preserve PWM frame
			  px[0] = 0x18 + i;
			  px[1] = 0x00;
			  HAL_I2C_Master_Transmit(&hi2c1, AS1130_ADDR, k, 2, -1);
			  HAL_I2C_Master_Transmit(&hi2c1, AS1130_ADDR, px, 2, -1);
			  px[0] = 0x18 + ((i + 1) % 132);
			  px[1] = 0x80;
			  HAL_I2C_Master_Transmit(&hi2c1, AS1130_ADDR, px, 2, -1);
		  }
		  HAL_Delay(15);
		  AS1130_reg_dump();
	  }
//
//	  HAL_GPIO_WritePin(LD2_GPIO_Port, LD2_Pin, tim_idx & 1);


//	  HAL_GPIO_WritePin(GPIOA, GPIO_PIN_10, i & 1); // toggle select

//	  HAL_GPIO_WritePin(GPIOA, GPIO_PIN_10, GPIO_PIN_SET);
//	  HAL_Delay(1);
//	  HAL_GPIO_WritePin(GPIOA, GPIO_PIN_10, GPIO_PIN_RESET);
//	  HAL_Delay(1);
////
//	  config[0] = MCP3002_CONFIG | (i << MCP3002_ODD_SIGN_Pos);
//	  e = HAL_SPI_TransmitReceive(&hspi1, config, rx, 2, -1);
//	  rx[0]++;
  }
  /* USER CODE END 3 */
}

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
/* USER CODE BEGIN 4 */
void AS1130_Init(void) {
	HAL_Delay(10); // give AS1130 >5ms to setup I2C address (as spec'd)
          // HAL_GPIO_TogglePin(GPIOB, GPIO_PIN_8);

  uint8_t step = 0;
	for(uint8_t i = 0; i < AS1130_SETUP_NUM_STEPS; i++) {
    e = HAL_I2C_Master_Transmit(&hi2c1, AS1130_ADDR, &(AS1130_setup[step]), AS1130_setup_sizes[i], -1);
    // e = HAL_I2C_Master_Transmit(&hi2c1, AS1130_ADDR, &(AS1130_setup[step]), 1, -1);
    // e = HAL_I2C_Master_Receive(&hi2c1, AS1130_ADDR, d, 1, -1);
    step += AS1130_setup_sizes[i];

//    if(hi2c1.ErrorCode != 0)
//      HAL_GPIO_WritePin(GPIOB, GPIO_PIN_8, GPIO_PIN_SET);
  }
}
void AS1130_reg_dump(void) {
  HAL_I2C_Master_Transmit(&hi2c1, AS1130_ADDR, h, 2, -1);
  HAL_I2C_Master_Transmit(&hi2c1, AS1130_ADDR, &zzz, 1, -1);
  HAL_I2C_Master_Receive(&hi2c1, AS1130_ADDR, d, 1, -1);

  HAL_I2C_Master_Transmit(&hi2c1, AS1130_ADDR, h, 2, -1);
  HAL_I2C_Master_Transmit(&hi2c1, AS1130_ADDR, &zz, 1, -1);
  HAL_I2C_Master_Receive(&hi2c1, AS1130_ADDR, g, 1, -1);

  g[0]++;
//  HAL_I2C_Master_Transmit(&hi2c1, AS1130_ADDR, k, 2, -1);
//  HAL_I2C_Master_Transmit(&hi2c1, AS1130_ADDR, &z, 1, -1);
//  HAL_I2C_Master_Receive(&hi2c1, AS1130_ADDR, a, 32, -1);
}

/* USER CODE END 4 */
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
