acrylic-origami/tail-3dof/stm/f103_test/Src/hand_ctrl.c

/*
 * hand_ctrl.c
 *
 *  Created on: Jul 4, 2020
 *      Author: derek-lam
 */

#include "main.h"
#include "hand_ctrl.h"

// az, el, radius
const int16_t HAND_CTRL_LUT[8][16][16][2][3] =
{ { { { { -269, 0, -379, }, { HAND_CTRL_LUT_NONE, HAND_CTRL_LUT_NONE, HAND_CTRL_LUT_NONE, }, },
{ { -274, 0, -365, }, { HAND_CTRL_LUT_NONE, HAND_CTRL_LUT_NONE, HAND_CTRL_LUT_NONE, }, },
{ { -278, 0, -349, }, { HAND_CTRL_LUT_NONE, HAND_CTRL_LUT_NONE, HAND_CTRL_LUT_NONE, }, },
{ { -283, 0, -334, }, { HAND_CTRL_LUT_NONE, HAND_CTRL_LUT_NONE, HAND_CTRL_LUT_NONE, }, },
{ { -288, 0, -317, }, { HAND_CTRL_LUT_NONE, HAND_CTRL_LUT_NONE, HAND_CTRL_LUT_NONE, }, },
{ { -293, 0, -300, }, { HAND_CTRL_LUT_NONE, HAND_CTRL_LUT_NONE, HAND_CTRL_LUT_NONE, }, },
{ { -299, 0, -282, }, { HAND_CTRL_LUT_NONE, HAND_CTRL_LUT_NONE, HAND_CTRL_LUT_NONE, }, },
{ { -306, 0, -263, }, { HAND_CTRL_LUT_NONE, HAND_CTRL_LUT_NONE, HAND_CTRL_LUT_NONE, }, },
{ { -313, 0, -243, }, { HAND_CTRL_LUT_NONE, HAND_CTRL_LUT_NONE, HAND_CTRL_LUT_NONE, }, },
{ { -320, 0, -221, }, { HAND_CTRL_LUT_NONE, HAND_CTRL_LUT_NONE, HAND_CTRL_LUT_NONE, }, },
{ { -329, 0, -197, }, { HAND_CTRL_LUT_NONE, HAND_CTRL_LUT_NONE, HAND_CTRL_LUT_NONE, }, },
{ { -339, 0, -169, }, { HAND_CTRL_LUT_NONE, HAND_CTRL_LUT_NONE, HAND_CTRL_LUT_NONE, }, },
{ { -351, 0, -137, }, { HAND_CTRL_LUT_NONE, HAND_CTRL_LUT_NONE, HAND_CTRL_LUT_NONE, }, },
{ { -366, 0, -94, }, { HAND_CTRL_LUT_NONE, HAND_CTRL_LUT_NONE, HAND_CTRL_LUT_NONE, }, },
{ { HAND_CTRL_LUT_NONE, HAND_CTRL_LUT_NONE, HAND_CTRL_LUT_NONE, }, { HAND_CTRL_LUT_NONE, HAND_CTRL_LUT_NONE, HAND_CTRL_LUT_NONE, }, },
{ { HAND_CTRL_LUT_NONE, HAND_CTRL_LUT_NONE, HAND_CTRL_LUT_NONE, }, { HAND_CTRL_LUT_NONE, HAND_CTRL_LUT_NONE, HAND_CTRL_LUT_NONE, }, },
},
{ { { -219, 0, -379, }, { HAND_CTRL_LUT_NONE, HAND_CTRL_LUT_NONE, HAND_CTRL_LUT_NONE, }, },
{ { -223, 0, -365, }, { HAND_CTRL_LUT_NONE, HAND_CTRL_LUT_NONE, HAND_CTRL_LUT_NONE, }, },
{ { -228, 0, -349, }, { HAND_CTRL_LUT_NONE, HAND_CTRL_LUT_NONE, HAND_CTRL_LUT_NONE, }, },
{ { -233, 0, -334, }, { HAND_CTRL_LUT_NONE, HAND_CTRL_LUT_NONE, HAND_CTRL_LUT_NONE, }, },
{ { -238, 0, -317, }, { HAND_CTRL_LUT_NONE, HAND_CTRL_LUT_NONE, HAND_CTRL_LUT_NONE, }, },
{ { -243, 0, -300, }, { HAND_CTRL_LUT_NONE, HAND_CTRL_LUT_NONE, HAND_CTRL_LUT_NONE, }, },
{ { -249, 0, -282, }, { HAND_CTRL_LUT_NONE, HAND_CTRL_LUT_NONE, HAND_CTRL_LUT_NONE, }, },
{ { -255, 0, -263, }, { HAND_CTRL_LUT_NONE, HAND_CTRL_LUT_NONE, HAND_CTRL_LUT_NONE, }, },
{ { -262, 0, -243, }, { HAND_CTRL_LUT_NONE, HAND_CTRL_LUT_NONE, HAND_CTRL_LUT_NONE, }, },
{ { -270, 0, -221, }, { HAND_CTRL_LUT_NONE, HAND_CTRL_LUT_NONE, HAND_CTRL_LUT_NONE, }, },
{ { -279, 0, -197, }, { HAND_CTRL_LUT_NONE, HAND_CTRL_LUT_NONE, HAND_CTRL_LUT_NONE, }, },
{ { -288, 0, -169, }, { HAND_CTRL_LUT_NONE, HAND_CTRL_LUT_NONE, HAND_CTRL_LUT_NONE, }, },
{ { -300, 0, -137, }, { HAND_CTRL_LUT_NONE, HAND_CTRL_LUT_NONE, HAND_CTRL_LUT_NONE, }, },
{ { -316, 0, -94, }, { -387, 0, 94, }, },
{ { HAND_CTRL_LUT_NONE, HAND_CTRL_LUT_NONE, HAND_CTRL_LUT_NONE, }, { HAND_CTRL_LUT_NONE, HAND_CTRL_LUT_NONE, HAND_CTRL_LUT_NONE, }, },
{ { HAND_CTRL_LUT_NONE, HAND_CTRL_LUT_NONE, HAND_CTRL_LUT_NONE, }, { HAND_CTRL_LUT_NONE, HAND_CTRL_LUT_NONE, HAND_CTRL_LUT_NONE, }, },
},
{ { { -169, 0, -379, }, { HAND_CTRL_LUT_NONE, HAND_CTRL_LUT_NONE, HAND_CTRL_LUT_NONE, }, },
{ { -173, 0, -365, }, { HAND_CTRL_LUT_NONE, HAND_CTRL_LUT_NONE, HAND_CTRL_LUT_NONE, }, },
{ { -178, 0, -349, }, { HAND_CTRL_LUT_NONE, HAND_CTRL_LUT_NONE, HAND_CTRL_LUT_NONE, }, },
{ { -182, 0, -334, }, { HAND_CTRL_LUT_NONE, HAND_CTRL_LUT_NONE, HAND_CTRL_LUT_NONE, }, },
{ { -187, 0, -317, }, { HAND_CTRL_LUT_NONE, HAND_CTRL_LUT_NONE, HAND_CTRL_LUT_NONE, }, },
{ { -193, 0, -300, }, { HAND_CTRL_LUT_NONE, HAND_CTRL_LUT_NONE, HAND_CTRL_LUT_NONE, }, },
{ { -199, 0, -282, }, { HAND_CTRL_LUT_NONE, HAND_CTRL_LUT_NONE, HAND_CTRL_LUT_NONE, }, },
{ { -205, 0, -263, }, { -397, 0, 263, }, },
{ { -212, 0, -243, }, { -390, 0, 243, }, },
{ { -220, 0, -221, }, { -382, 0, 221, }, },
{ { -228, 0, -197, }, { -374, 0, 197, }, },
{ { -238, 0, -169, }, { -364, 0, 169, }, },
{ { -250, 0, -137, }, { -352, 0, 137, }, },
{ { -266, 0, -94, }, { -336, 0, 94, }, },
{ { HAND_CTRL_LUT_NONE, HAND_CTRL_LUT_NONE, HAND_CTRL_LUT_NONE, }, { HAND_CTRL_LUT_NONE, HAND_CTRL_LUT_NONE, HAND_CTRL_LUT_NONE, }, },
{ { HAND_CTRL_LUT_NONE, HAND_CTRL_LUT_NONE, HAND_CTRL_LUT_NONE, }, { HAND_CTRL_LUT_NONE, HAND_CTRL_LUT_NONE, HAND_CTRL_LUT_NONE, }, },
},
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
{ { -60, -370, 65, }, { 60, -370, -65, }, },
{ { -50, -368, 55, }, { 50, -368, -55, }, },
},
{ { { -91, -396, 145, }, { 192, -396, -145, }, },
{ { -87, -394, 141, }, { 187, -394, -141, }, },
{ { -82, -392, 137, }, { 182, -392, -137, }, },
{ { -77, -390, 132, }, { 178, -390, -132, }, },
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
