acrylic-origami/tail-3dof/stm/f103_test/Inc/main.h

#define LD_Pin GPIO_PIN_13
#define LD_GPIO_Port GPIOC
#define TIM2_J1_PWM_Pin GPIO_PIN_0
#define TIM2_J1_PWM_GPIO_Port GPIOA
#define TIM2_J2_PWM_Pin GPIO_PIN_1
#define TIM2_J2_PWM_GPIO_Port GPIOA
#define TIM2_J0_PWM_Pin GPIO_PIN_2
#define TIM2_J0_PWM_GPIO_Port GPIOA
#define Xin_Pin GPIO_PIN_3
#define Xin_GPIO_Port GPIOA
#define Yin_Pin GPIO_PIN_0
#define Yin_GPIO_Port GPIOB
#define Zin_Pin GPIO_PIN_1
#define Zin_GPIO_Port GPIOB
#define LIMSW2_Pin GPIO_PIN_12
#define LIMSW2_GPIO_Port GPIOB
#define LIMSW2_EXTI_IRQn EXTI15_10_IRQn
#define SERVO1_NSEL_Pin GPIO_PIN_8
#define SERVO1_NSEL_GPIO_Port GPIOA
#define SERVO2_NSEL_Pin GPIO_PIN_9
#define SERVO2_NSEL_GPIO_Port GPIOA
#define LIMSW1_Pin GPIO_PIN_11
#define LIMSW1_GPIO_Port GPIOA
#define LIMSW1_EXTI_IRQn EXTI15_10_IRQn
#define HAND_CTRL_EN_N_Pin GPIO_PIN_12
#define HAND_CTRL_EN_N_GPIO_Port GPIOA
#define SERVO1_Pin GPIO_PIN_15
#define SERVO1_GPIO_Port GPIOA
#define SERVO2_Pin GPIO_PIN_3
#define SERVO2_GPIO_Port GPIOB
#define MIN_HOMING_CCR (-RNG_HW)
#define HOMING_TICK 40 // ms
#define HOMING_STRIDE 4 // CCR units
#define NUM_HAND_CTRL_BUF 64
#define NUM_HAND_CTRL_AX 3
#define HAND_CTRL_BUF_DS 2 // downsampling factor (simple skipping)
#define HAND_CTRL_DEADBAND 3
#define HAND_R0 135 // UNFLOAT 0.470
#define HAND_R1 158 // UNFLOAT 0.578
#define NUM_POS 128
#define NUM_POS_MSK 0x3F
#define NUM_POS_Pos 6
#define NUM_JOINTS 3
#define NUM_POS_DERIV 2
#define POS_STRIDE (NUM_JOINTS * NUM_POS_DERIV)
#define NUM_POS_ELE (NUM_POS * POS_STRIDE)
#define MAX_TF_LIM 2514 // 95th percentile of 440 speeds calculated from random-ish sampling
#define SPEEDUP_FACTOR_N 9
#define SPEEDUP_FACTOR_D 4
#define UART_BUF_SIZE 12
#define TRAJ_ITER_LIM 3
#define TIM2_FREQ 50
#define LOWER_LIM_BREAK_TIMEOUT (TIM2_FREQ)
#define UPPER_LIM_BREAK_INIT (TIM2_FREQ / 4)
#define MCP3002_CONFIG (0b11010000 << 8)
#define MCP3002_ODD_SIGN_Pos 13
