acrylic-origami/tail-3dof/stm/g431_test/Inc/motor.h

/*
 * motor.h
 *
 *  Created on: May 22, 2020
 *      Author: derek-lam
 */

#ifndef MOTOR_H_
#define MOTOR_H_

#include "main.h"

void motor_tick(void);

#define TIM1_POL 0b0
#define TIM1_POL_MSK 0b101010101010
#define NUM_CTRL_D_BUF 4

#define PWMIN2TARG_N 2
#define PWMIN2TARG_D 13

#define MIN_PWMIN_PULSE 500
#define MAX_PWMIN_PULSE 2500
#define PWMIN_LIM 900

#define BRAKE_CCER 0x444
#define BRAKE_CCR 192

#define MAX_SOFT_START_COEFF 512

#define TARG0 375
#define ENC2TARG_N 18
#define ENC2TARG_D 11
#define CTRL2CCR_N 6
#define CTRL2CCR_D 1
#define MAX_CCR 230
#define MAX_TICK 70
#define HALL_TICK_BLACKOUT 3 // number of TIM6 cycles to blackout on timer-based ticks
#define PCCR 220
// Note about PCC:
// high-side PWM just to recharge bootstrap cap; also sets absolute max CCR
// @2 downsampling, 55ccr = 260us off-time -> given 10-ohm ESR cap, 63us time constant, we're fine (2%)

#define CTRL_I_N 1
#define CTRL_I_D (TIM6_FREQ * 4)
// fraction of max ccr for max I ctrl
#define MAX_CTRL_I_N 5
#define MAX_CTRL_I_D 7
#define MAX_CTRL_I (CTRL_I_D * MAX_CCR / CTRL_I_N * CTRL2CCR_D / CTRL2CCR_N * MAX_CTRL_I_N / MAX_CTRL_I_D)
#define CTRL_P_N 1
#define CTRL_P_D 1

#endif /* MOTOR_H_ */
