acrylic-origami/tail-3dof/stm/f103_test/Inc/as1130.h

/*
 * as1130.h
 *
 *  Created on: May 14, 2020
 *      Author: derek-lam
 */

#ifndef AS1130_H_
#define AS1130_H_

#include <stdint.h>

#define AS1130_SETUP_NUM_STEPS 16
#define AS1130_ADDR            0b01101110
#define NUM_PXS 132
void AS1130_Init(void);
uint8_t AS1130_blit(uint8_t *A, uint16_t *Adims, uint16_t *loc, uint16_t *scale);
uint8_t AS1130_xy2idx(uint8_t x, uint8_t y);

#define ARRAY_ROWS 12
#define ARRAY_COLS 6
#define ARRAY_ROW_FOLDING 2

#endif /* AS1130_H_ */
