acrylic-origami/tail-3dof/stm/f103_test/Inc/as1130_pat.h

/*
 * as1130_pat.h
 *
 *  Created on: Jul 5, 2020
 *      Author: derek-lam
 */

#ifndef AS1130_PAT_H_
#define AS1130_PAT_H_

#include "main.h"

// hardcoded bitmaps
#define NBUMP 32

uint8_t sin2_t(int16_t x, int16_t y, int16_t t);

#endif /* AS1130_PAT_H_ */
