acrylic-origami/tail-3dof/stm/f303_test/Inc/consts.h

/*
 * consts.h
 *
 *  Created on: Apr 30, 2020
 *      Author: derek-lam
 */

#ifndef CONSTS_H_
#define CONSTS_H_

#define EPS 1 // UNFLOAT 1E-3
#define FEPS 1E-3
#define _TTW 24
#define _TW 16
#define _W 8
#define _HW 4

#define INV_PI 82
#define I_PI 804

#endif /* CONSTS_H_ */
