acrylic-origami/tail-3dof/(commit log)

2020-03-28 Rejig peripherals
    - Use TIM3 and TIM4 (slave) to emit pulse train for stepper instead of SPI
    - Use TIM2 as both the servo output timer and as the kinematic step timer
    (20ms is a pretty convenient step size)
    - Give servos a 100-step resolution via TIM2 counter size
    - Enable GPIO interrupt for limit switch detection
    - Use TIM1 to generate 32-period WS signal for microphone (in case it
    needs it)
2020-03-28 Draft kinematic controller
    Assume the stepper is close enough to synchronized with the kinematic
    steps (i.e. it lands on each waypoint more or less at the same time
    as the 20ms servo tick interrupt). Then change the pulse width on the
    steppers while setting a stepper trajectory using TIM3 ARR + TIM4 CCR.
    Ignore the non-HAL I2C stuff for now: mistakenly didn't see much better
    HAL functions.
    [consts.h, it_util.c, it_util.h, main.c]
2020-03-28 Use HAL I2C
    Move setup into main loop init. Note main loop px updates are also
    much easier: no need for flags, just send and forget when we want.
    Downside is if px updates come too often, we have to drop that frame
    instead of 1-buffering, but that's not a big problem.
    [consts.h, it_util.h, main.c, main.h]
2020-03-28 Make SPI full duplex
    Rx-only SPI doesn't allow circular DMA in Rx only (probably because you don't
    expect to get infinite data from things without writing to them first).
    Instead, just make it full duplex and don't use MOSI.
    [tail-ctrl.ioc]
2020-03-28 Fire-and-forget I2S + EXTI
    After examining the HAL code for SPI, I'm fairly confident that in ciruclar
    mode it won't stop receiving bytes, which is really good for us. Therefore
    the init is just a fire-and-forget call, where I'll process in the main
    loop from `mic_buffer`.
    [main.c, tail-ctrl.ioc]
2020-03-29 Initial kin-sim, with cubic spline interp
    This interp isn't very stable as can be seen by spline-stable, when the
    times get really long relative to the velocities on each side. Basically,
    the system is too "heavy", so the variables overshoot by a lot. This is
    just inherent to the solution, and higher-order polynomials (at the min
    distance solution) surprisingly aren't better.
    Instead, we want to move to a solution with predictable overshoot.
2020-04-21 Initial commit for kinetics test
    Will end up being the central codebase for alpha motion control
    [f072_kin_test Debug.cfg]
2020-04-27 Initial mic test commit
    [f072_mic_test Debug.cfg]
2020-05-02 Alpha stable (but slow) kinetics
    Major bug fixes to the motion planning system. Notably, many corner cases
    added to the path planner, as well as a switchover from exact solution
    of really awful abs + quadratic equation to numerical solution with
    elliptical approximation for speed-torque curve.
    These fixes came from the first solid wet test, with a simple but non-
    trivial wag with joints 0 and 2 at constant endpoint position, while
    joints 1 and 2 had non-constant velocities. The original formulation
    had symmetry problems, where the arm returned to slightly different
    positions depending on the signs of the parameters. I discovered this
    came from several sources, ranging from minor things like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
    [f072_kin_test.ioc, kin.c, kin.h, main.c, main.h]
2020-05-04 Initial int kinematics attempt
    Try to speed everything up by using ints for almost everything in the
    kinematic code. Speedup of >4x so far, have yet to use LUTs on the trig
    functions in inv_kin.
2020-05-04 Initial commit of AS1130 tester on F072
    Seequentially activates LEDs. Tries open-testing.
    [f072_test Debug.cfg]
2020-05-04 Int math debugging: sqrts cut the mantissa in half, not by constant amount
2020-05-07 Fix small but major errors
    [kin.c]
2020-05-07 Fix inv kin int programming translation errors
    [kin.c]
2020-05-08 Various small math fixes + track consts.h
    [consts.h, traj.c, traj.h]
2020-05-16 Fix overflow errors in timing solver, choose between ambiguous positions
    Numbers in the timing solver (due to the quadratic) were getting really big
    if they weren't pared down early enough.
    Also, in the inverse kinematics, there's usually a choice of joint 0 angle
    so we're going to snap it to the previous joint 0 to make the motion more
    natural.
    [f072_kin_test.ioc, kin.c, kin.h, main.c, main.h, traj.c, traj.h]
2020-05-16 Start tracking stm32-mini final-track code
    [f103_test Run.cfg]
2020-06-06 New kinematics (Jacobian + inertia calculation) + ESC control attempt
    Tried to control the Hobbywing Quicrun ESC as a speed-torque controller,
    but it wouldn't hold position properly, instead trying to advance when it
    stalled. This led to the migration to a dumbe 3-phase driver.
    Also new kinematics have landed: Jacobian (more specifically inverse Jacobian
    plus a bunch of routines from CLAPACK) and the fwd kinematics for inertia
    calculations, also originally for tuning the control algorithm for J0
    (may become obsolete if the control is sufficiently robust on the independent
    motor driver)
    [f103_test.ioc, kin.c, kin.h, main.c, main.h, traj.h]
2020-06-13 Fix kinematics and producer-consumer buffering
    Inverse kinematics had a couple of calculation bugs that are detailed in
    `ctrl/ctrl_test.c`.
    Producer-consumer had lots of problems with choreographing buffer
    freshness, consumer empty and advancing the starting point for the
    interpolation. All of the flags were restructured to avoid the
    multitude of races that were causing sudden jumps in the trajectory.
    [f103_test Run.cfg]
2020-06-16 Fix Jacobian, begin testing lights
    [as1130.c, as1130.h, consts.h, f103_test.ioc, kin.c, main.c]
2020-06-17 Fix interpolation for lights
    Now downscaled images will be sampled at an accurate and consistent
    point in the target image.
    [as1130.c, as1130.h, main.c]
2020-06-20 Fix lerp math errors & add derivative to calculation
    The derivative will be used to perform smooth on-the-fly switching of
    target positions.
    [kin.h, main.c, main.h, traj.c, traj.h]
2020-06-29 Track G431 ESC code
2020-06-29 Add homing functionality
    Due to the newly added spring, the time-0 j0 position isn't known. Homing
    compesses the spring to hit the bottom limit switch, then compensates for the
    j0 position thereafter.
2020-06-29 Improve hit rate and feel by realtime targeting & tuning ranges
    - Return two sol'ns from invkin
    - Adjusting control ranges and ALPHA for better hit-rate
    - Refine unreachable logic
    - Change trajectory logic to continuously use latest hand control
    - Speed up, make timing less conservative by SPEEDUP_FACTOR
    - Improved debugging data packed into UART
    - LPF in final control stage
    - `_con_fresh` definition and new stashes (esp tick_start_buf)
    - Refine logic in conversions
    - Housekeeping: Flatten arrays that are mem*'d
2020-06-29 lerp bugfixes
    - Fix pointer problem with lerp
    - Fix lerp derivative issues
    - Wrong derivative used in t'
    - Smoothstep over linear in overlapping case for velocity
    matching at endpoints
    Also housekeeping: forgot to stage commented-out error handling code
    (servo monitoring, which is currently unused)
    [main.c, traj.c, traj.h]
2020-07-05 Try out fixed premade paths and random walks
    [main.c, traj.h]
2020-07-05 Track F303 code
    Changes include:
    - (slightly broken) ikfast solution downconverted to C running on-chip
    - Lookup table from proper C++ IKfast generated on PC (code included in `ctrl`
    [f303_test Run.cfg]
2020-07-11 Track useful files, add README
    [bom.xlsx]
2020-07-11 Use a lookup table for inverse kinematics
    Rather than compute them on the fly, given the coarseness of the hand
    controls, just use a lookup table with enough resolution to map all
    the joint angles to a hand control space with good coverage.
